d4chinchilla/docs/README.md

# Project Chinchilla Documentation

This repository contains all the documentation for project chinchilla.
The documentation is written in markdown and maybe duplicated in it's specific
repository.
The root of the documentation is [overview.md](overview.md).
