d4chinchilla/docs/buffer/overview.md

# Buffer Overview
Buffer Lead: [Matthew Johns](http://github.com/mjohns4)

Log File: [buffer/log.md](log.md)

## Microcontroller
This buffer uses an STM NUCLEO-L432KC microcontroller board. This is produced by ST Microelectronics and is based off the STM32L432KCU6 microcontroller, which is in turn based off an Arm Cortex-M4 core.

Useful links:

[mbed description](https://os.mbed.com/platforms/ST-Nucleo-L432KC/)

[STM website](https://www.st.com/content/st_com/en/products/evaluation-tools/product-evaluation-tools/mcu-eval-tools/stm32-mcu-eval-tools/stm32-nucleo-boards/nucleo-l432kc.html)

[MCU datasheet](https://www.st.com/resource/en/datasheet/stm32l432kc.pdf)
