d4chinchilla/docs/report/appendixE/minutes.md

# Minutes

## 15:00 16/02/2019
attendees: Francis, Hugo, Mark, Matt J, Tom    
place: level 3 Zepler labs    

- We met and discussed possible project options
- We ruled out basic sensors as those would be too simple
- We eventually decided on a project to detect sound angle over other proposed projects
- Decided project would have a web ui
- Deciding between il matto & display and an LED ring to display output onboard
- Discussed power requirements, and pre-amps
- It would detect sound using four microphones
- It would have a 3D printed case
- Using microcontroller for data collection
- Discussed Raspberry Pi or FPGA for processing
- Split up code into 5 block sections
- Split up project into block sections
- Made github for code and docs

## 10:00 18/02/2019
attendees: All    
place: level 2 Zepler labs    

- Discussed idea from last meeting with everybody
- Confirmed everybody was OK with basic idea
- Specified details for requirements
- Detailed processing methods
- Given everybody access to github and explain usage
- Assigned individual leads for each block

## 11:50 19/02/2019
attendees: All + Tim Forcer
place: level 2 Zepler labs

- Discussed project idea and specific details
- We were advised on the importance of specifying interfaces
- We were advised that we should make test data so that each block can be tested seperately to each other
- We were told about the format of the project and advised about individual roles

## 15:00 19/02/2019
attendees: All    
place: level 3 Zepler labs    

- Discussed plan in detail in response to Tim Forcer's comments
- Established schematics for some components
- Confirmed which parts are needed
- Found parts from RS components and Onecall (Farnell)
- Created parts list

## 15:00 21/02/2019
attendees: Hugo, Mark, Will    
place: level 3 Zepler labs    

- Discussed design summary
- Discussed individual roles
- Discussed individual module specifications
- Discussed costing
- Discussed construction methods
- Discussed Risk assessment
- Discussed project proposal form
