d4chinchilla/docs/report/appendixA/DesignCompletionForm-complete.pdf

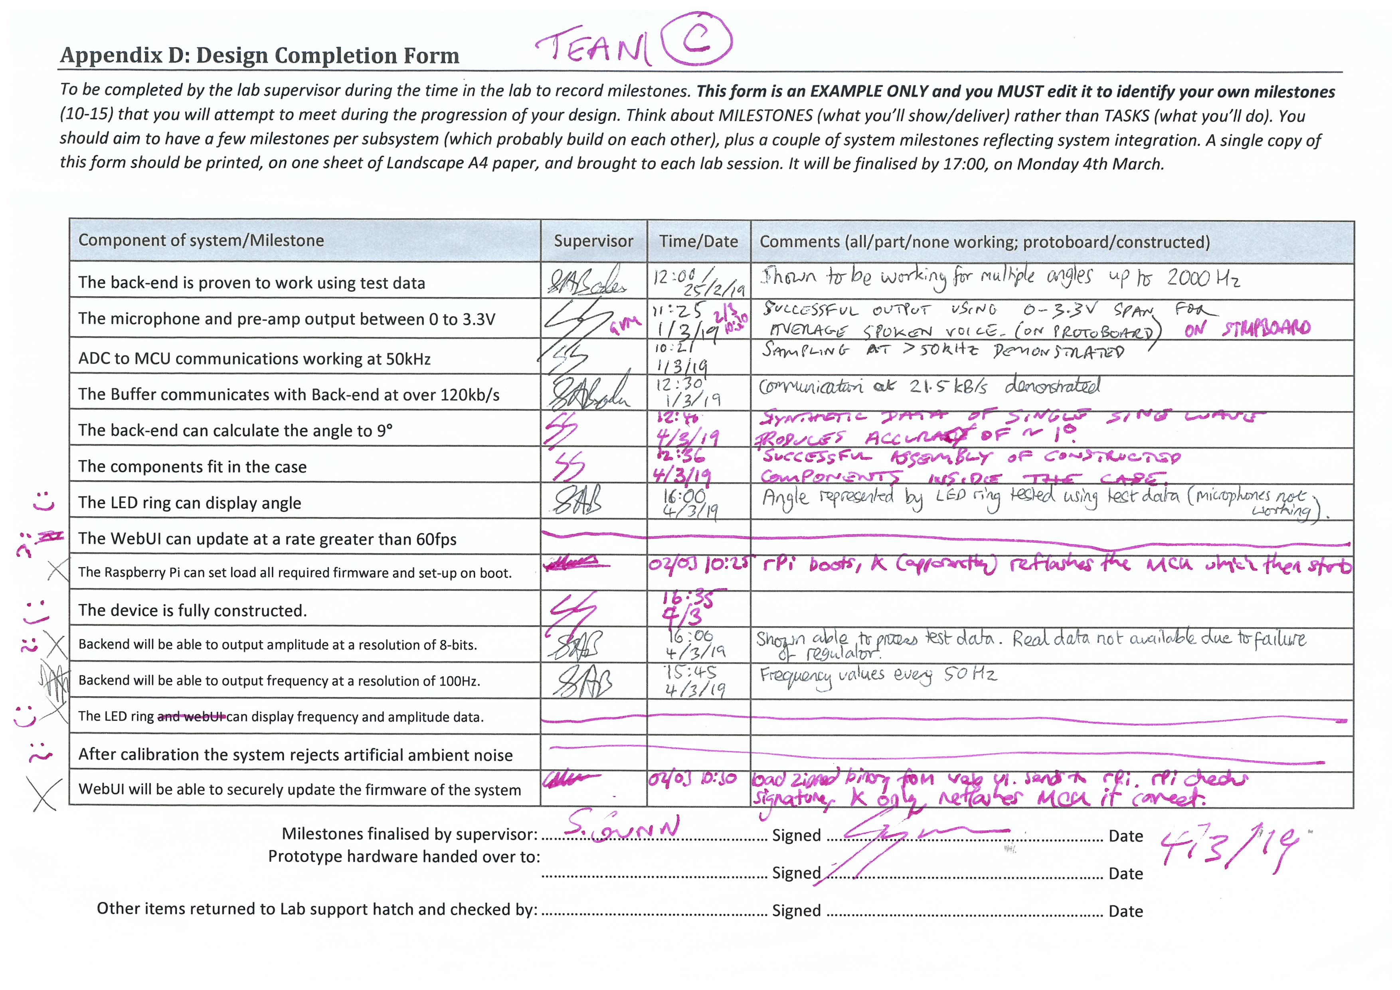
[picture p8: page 1]
