d4chinchilla/docs/report/appendixB/actualprojectactivities/francis.pdf

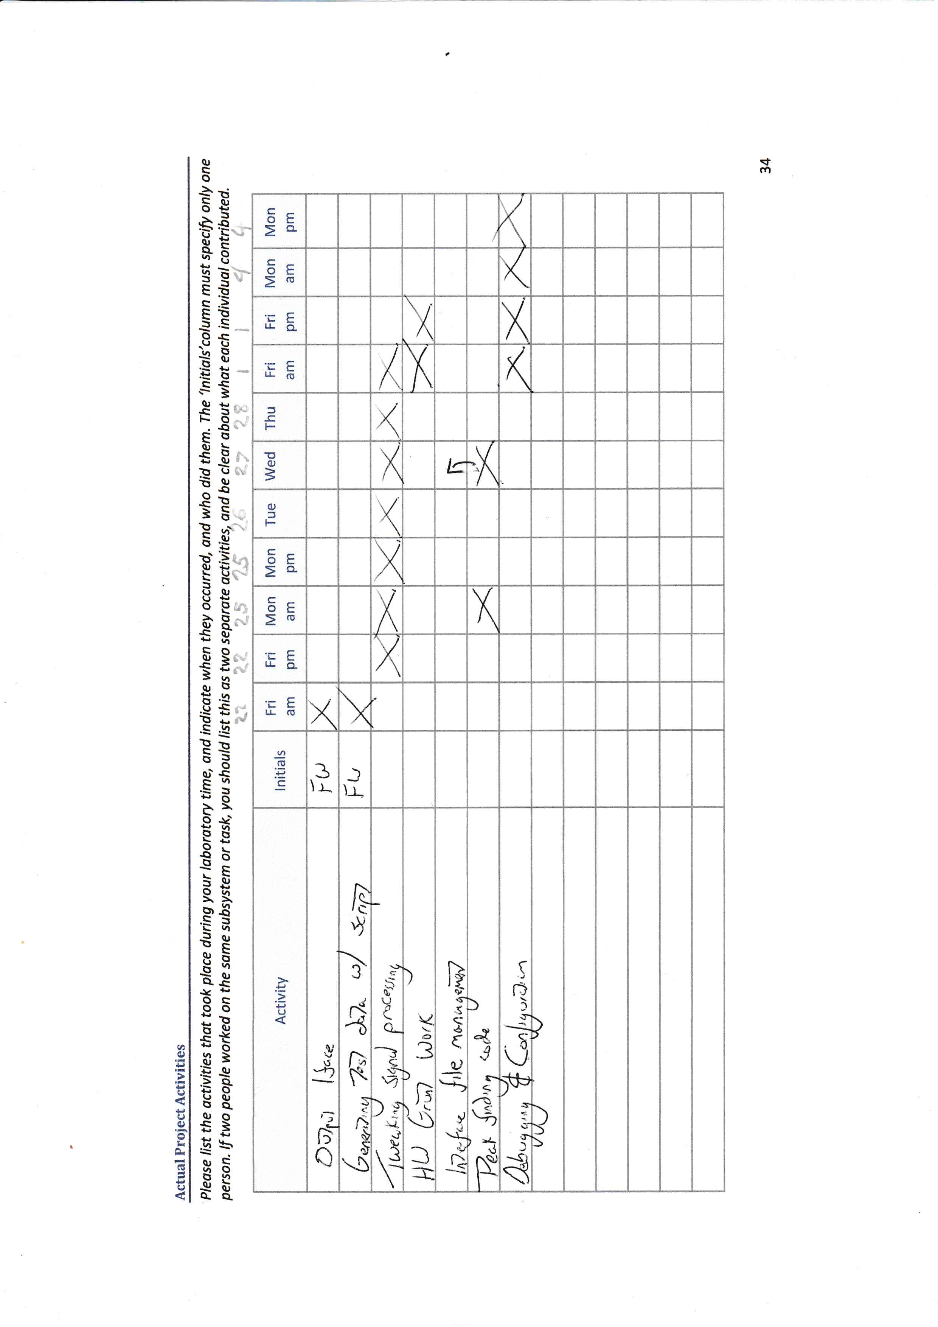
[picture p9: page 1]
