d4chinchilla/docs/hardware/concept_render.png

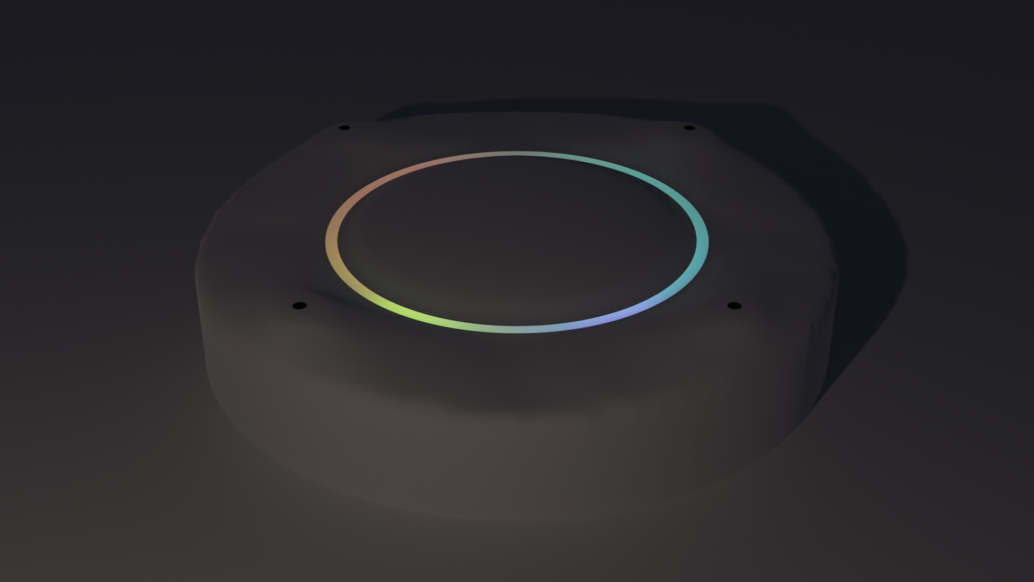
hardware/concept_render.png
