d4chinchilla/docs/Photos/00000PORTRAIT_00000_BURST20190304165032344.jpg

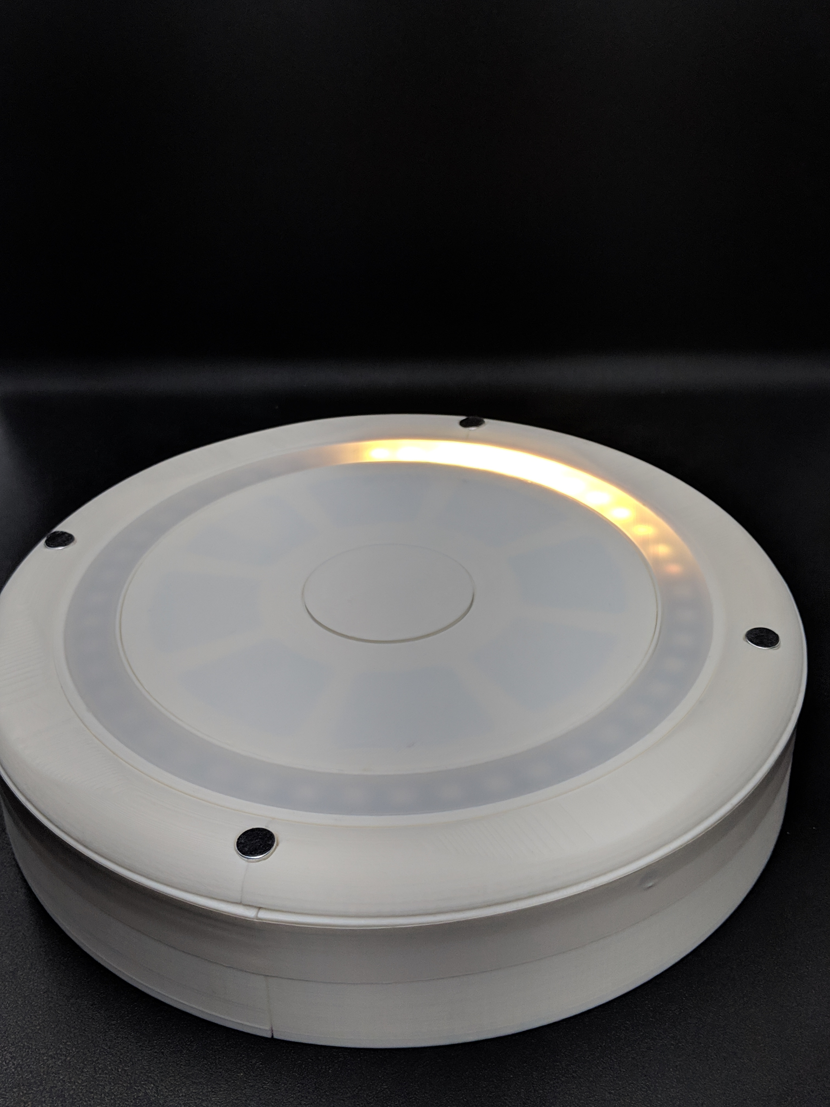
Photos/00000PORTRAIT_00000_BURST20190304165032344.jpg
