d4chinchilla/docs/Photos/00000PORTRAIT_00000_BURST20190304165042817.jpg

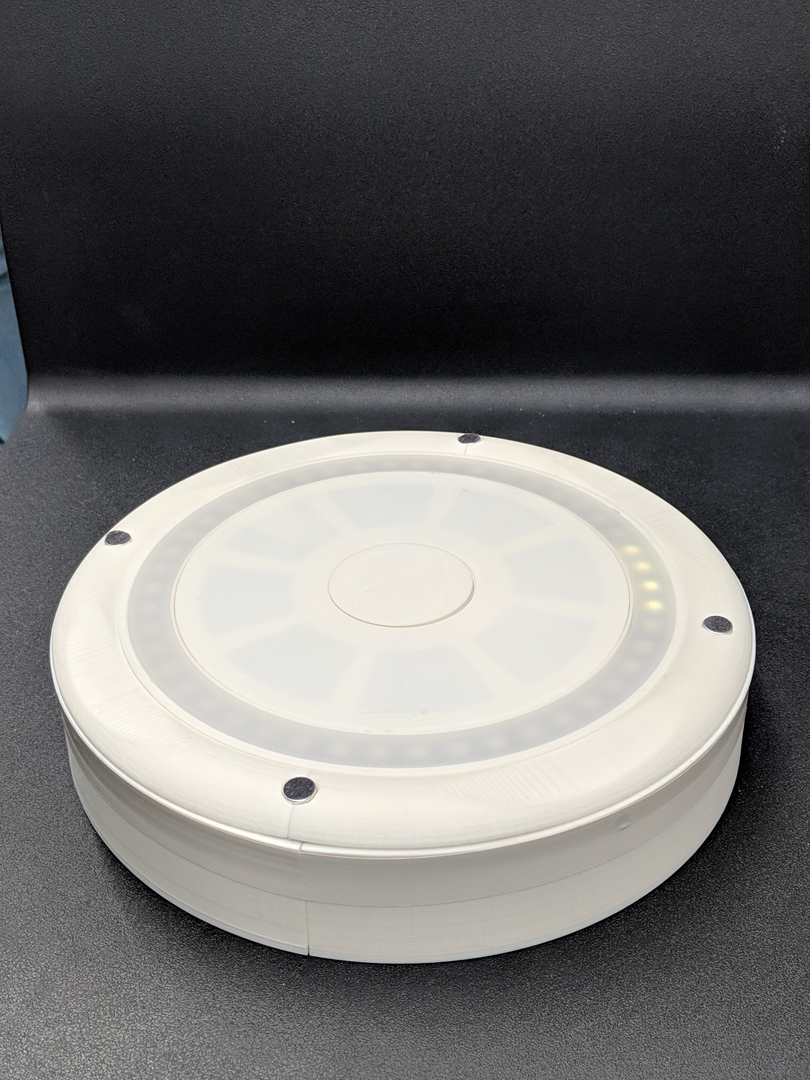
Photos/00000PORTRAIT_00000_BURST20190304165042817.jpg
