d4chinchilla/docs/Photos/00100dPORTRAIT_00100_BURST20190304165030741_COVER.jpg

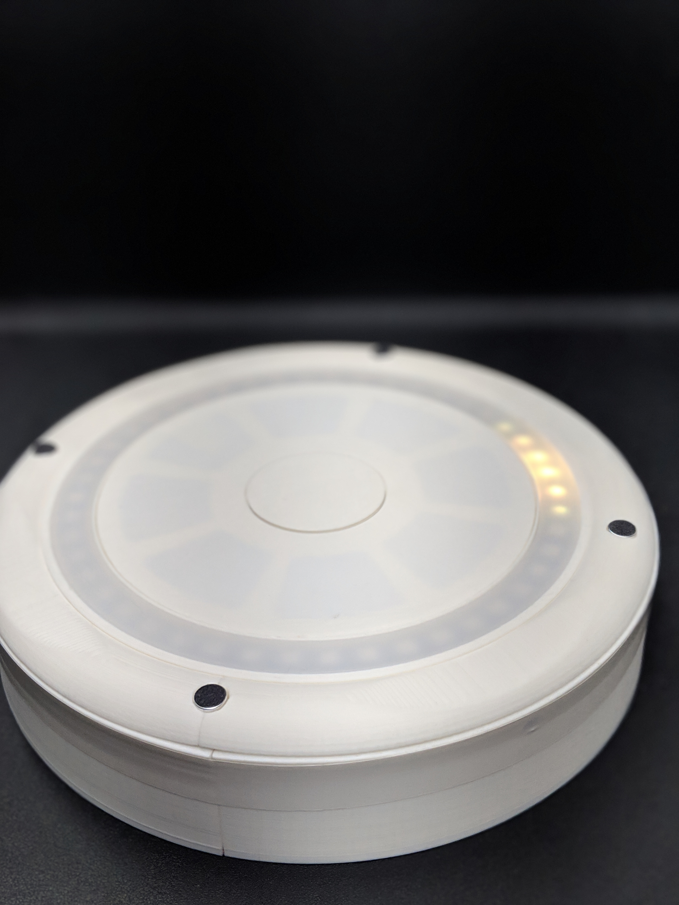
Photos/00100dPORTRAIT_00100_BURST20190304165030741_COVER.jpg
