d4chinchilla/docs/report/appendixB/actualprojectactivities/johns.png

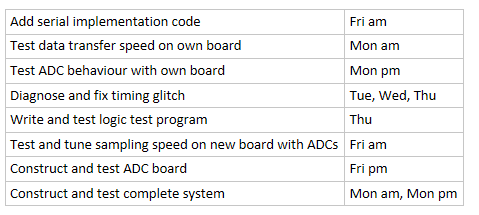
report/appendixB/actualprojectactivities/johns.png
