d4chinchilla/docs/report/appendixB/actualprojectactivities/mark.jpg

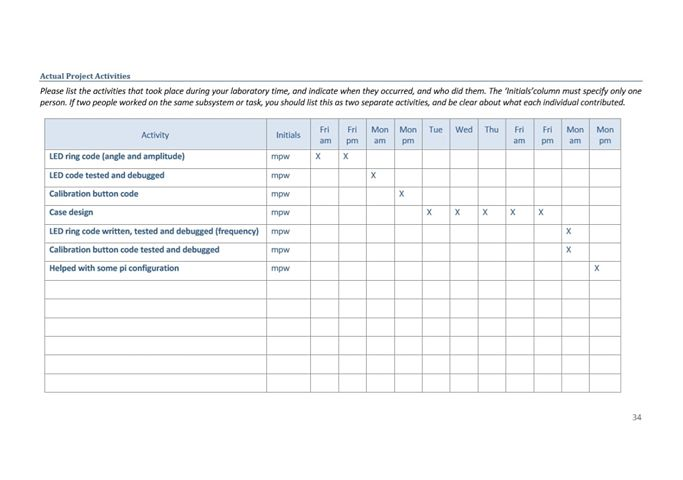
report/appendixB/actualprojectactivities/mark.jpg
