d4chinchilla/docs/report/appendixB/actualprojectactivities/will.png

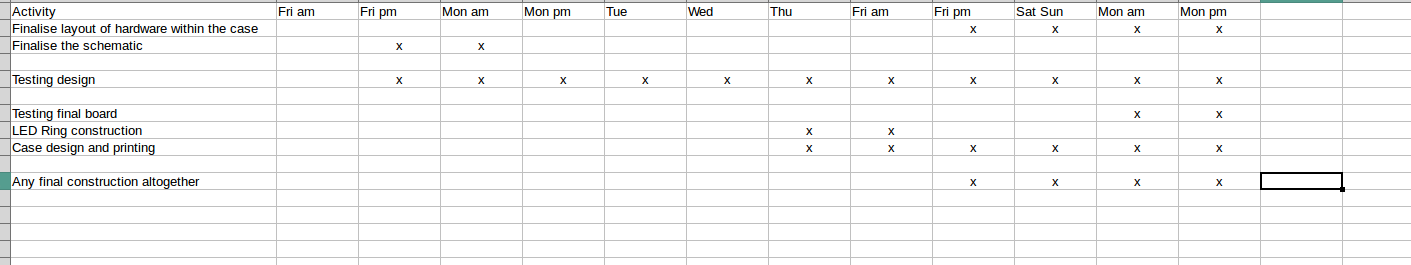
report/appendixB/actualprojectactivities/will.png
