d4chinchilla/docs/report/appendixC/schematic.png

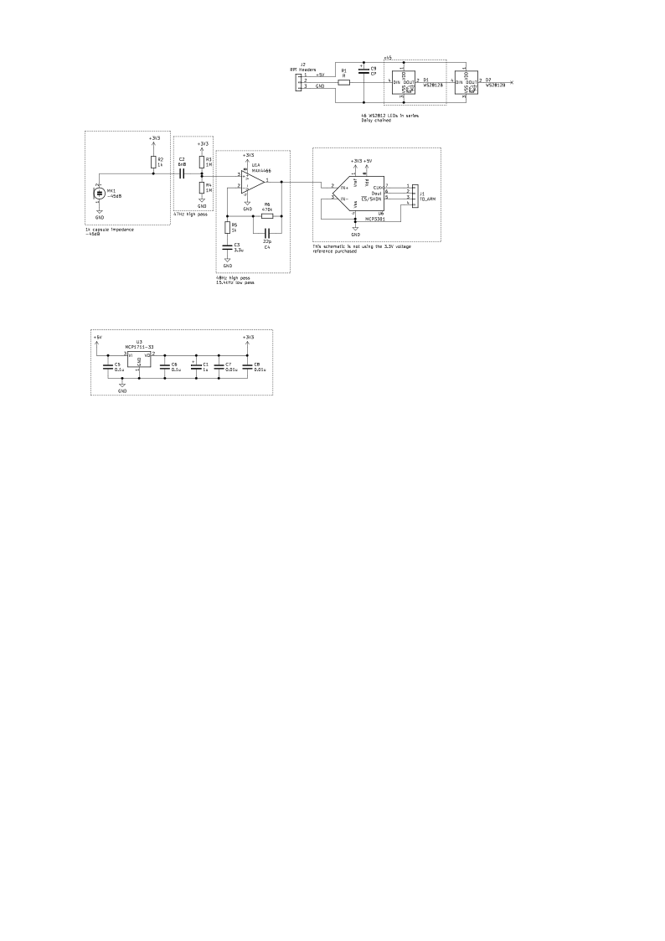
report/appendixC/schematic.png
