d4chinchilla/docs/report/pictures/FinalProduct.jpg

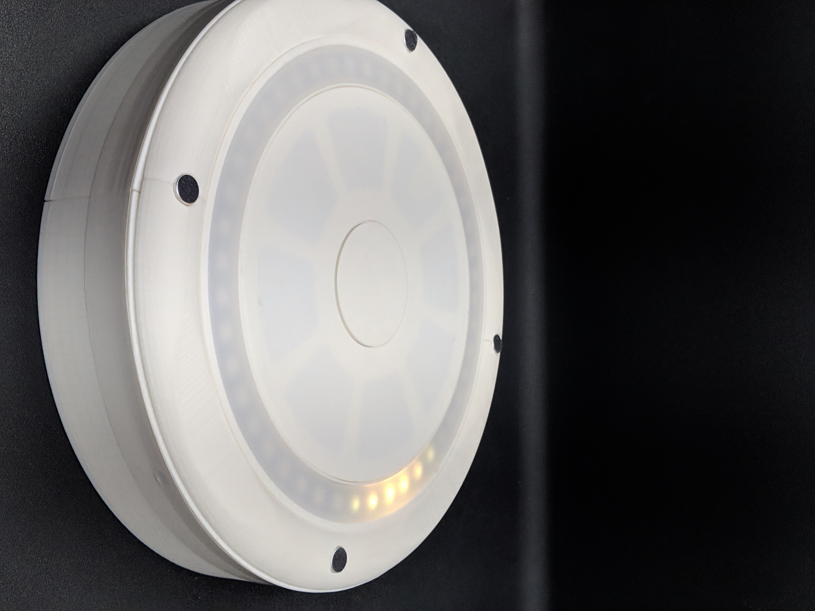
report/pictures/FinalProduct.jpg
