d4chinchilla/docs/hardware/cost_estimation.ods

Number of units: | 1000 |  |  | 1000 is quite a high volume of units to be selling of this product.
 |  |  |  | 100 Would probably be more realistic depending on the final price but
Costing assumptions: |  |  |  | any reasonable RRP would be unattainable with that low a volume.
Design is refined into a single 4 layer board
The ARM chip is integrated into the main board
Raspberry pi remains a plugin module to minimise redesign costs
An additional filter is implemented to reduce noise
Alternate parts are not sourced
No special passives are required
Case is injection moulded at volume
Items in italics have estimate costs
Per unit costs: | £82.52 |  |  | Amortised cost per unit: | £142.91
Item | Qty | Cost per @vol | Total cost | Item | Cost | Additional cost per unit
STM32L432KC | 1 | £2.27 | £2.27 | Compliance testing | £2,000.00 | £2.00
Raspberry Pi | 1 | £21.22 | £21.22 | Tooling costs | £800.00 | £0.80
ADC MCP3301 | 4 | £1.35 | £5.40 | Development hours | £40,000.00 | £40.00
LDO MCP1711 | 4 | £0.20 | £0.82 | Development components | £110.88 | £0.11
WS2812 | 46 | £0.34 | £15.64 | Development overheads | £100,000.00 | £100.00
OpAmp LMV358ID | 4 | £0.14 | £0.56
Vref MCP1501-33 | 4 | £0.46 | £1.82 | Total cost per unit: | £225.43
AOM-654P-R | 4 | £0.47 | £1.87
Preamp MAX4466 | 4 | £0.27 | £1.08 | Going on a rule of cost * 1.5 as a rule of thumb
MicroSD Card | 1 | £4.99 | £4.99 | Cost * 2 would be ideal but is an accessibility product
Passives | 1 | £2.00 | £2.00
Battery (inc management) | 1 | £15.00 | £15.00 | Cost * 1.5: | £338.14
Mainboard PCB | 1 | £5.25 | £5.25
Board assembly | 1 | £0.60 | £0.60 | Need to take into account 20% vat
Case | 1 | £4.00 | £4.00
Final assembly and test | 1 | £10.00 | £10.00 | Recommended Retail Price: | £405.77
