d4chinchilla/docs/hardware/parts.csv

Item | Quantity | Unit cost | Total | Link
STM32 Nucleo-32 STM32L432KC Dev. Board | 1 | £8.32 | £8.32 | https://uk.rs-online.com/web/p/processor-microcontroller-development-kits/1438574/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
MCP3301-CI/P Analogue to Digital Converter, 13 bit, 100 kSPS, Differential, Serial, SPI, Single, 4.5 V | 4 | £1.75 | £7.00 | https://onecall.farnell.com/microchip/mcp3301-ci-p/ic-13bit-adc-1ch-dip8-3301/dp/1332099
1MS1T1B5M1QE Toggle Swich | 1 | £1.69 | £1.69 | https://onecall.farnell.com/multicomp/1ms1t1b5m1qe/switch-spdt-2-0a-250v/dp/9473378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
MCP1711T-33I/OT 3.3V LDO | 4 | £0.24 | £0.98 | https://onecall.farnell.com/microchip/mcp1711t-33i-ot/ldo-fixed-3-3v-0-15a-sot-23-5/dp/2851552?st=mcp1711
Alitove 100 pcs ws2812B addressable LED pixel light rgb 5V DC | 1 | £17.99 | £17.99 | https://www.amazon.co.uk/ALITOVE-100pcs-WS2812B-Addressable-Arduino/dp/B01JTVRNFA?srs=10938069031
RS Pro Power Bank | 1 | £17.89 | £17.89 | https://uk.rs-online.com/web/p/power-banks/7757517/?searchHistory=%7B%22enabled%22%3Atrue%7D
LVM358 Opamps | 4 | £0.56 | £2.24 | https://onecall.farnell.com/texas-instruments/lmv358id/op-amp-dual-low-volt-rro-p-soic8/dp/1105913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
MCP1501T-33E/CHY 3.3V References | 4 | £0.60 | £2.41 | https://onecall.farnell.com/microchip/mcp1501t-33e-chy/voltage-ref-series-fixed-3-3v/dp/2857779
MAX446EXK+T Microphone Preamp | 4 | £0.32 | £1.28 | https://onecall.farnell.com/maxim-integrated-products/max4466exk-t/audio-amp-600khz-sc-70-5/dp/2514501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
AOM-6545P-R Microphone | 4 | £1.27 | £5.08 | https://onecall.farnell.com/projects-unlimited/aom-6545p-r/microphone-omni-pcb-9-4mm/dp/1193036?st=1193036
Raspberry Pi 3 | 1
Micro SD Card for Pi | 1
Perfboard | N/A
Female Pin Headers | N/A
 |  | Total | 64.88
