d4chinchilla/docs/forms/submitted_requisitions_form.xlsx

Group: Chinchilla |  | Project leader: Hugo McNally | Supplier: Onecall
Column1 | Column2 | Column3 | Column4 | Column5 | Column6
Quantity | Suppliers stock code | Description | Unit price (ex. VAT) | Total price (ex. VAT) | In stock
8 | 1332099 | MCP3301-CI/P ADC | 1.75 | 14 | 626
8 | 2851552 | MCP1711T-33I/OT 3.3V LDO | 0.244 | 1.95 | 794
1 | 2801872 | LED strip | 23.2 | 23.2 | 192
8 | 2857779 | MCP1501T-33E/CHY 3.3V Reference | 0.603 | 4.82 | 3.62
8 | 2514501 | MAX4466EXK+T Microphone Preamp | 0.319 | 2.55 | 1637
8 | 1193036 | AOM-6545P-R Microphone | 1.27 | 10.16 | 22
8 | 1105913 | LMV358 OpAmp | 0.556 | 4.45 | 25154
2 | 9473378 | 1MS1T1B5M1QE Toggle Switch | 1.67 | 3.34 | 45626
Group: Chinchilla |  | Project leader: Hugo McNally | Supplier: RS
Column1 | Column2 | Column3 | Column4 | Column5 | Column6
Quantity | Suppliers stock code | Description | Unit price (ex. VAT) | Total price (ex. VAT) | In stock
1 | 775-7517 | RS Pro Power Bank | 17.89 | 17.89 | 142
1 | 143-8574 | Nucleo-32 STM32L432KC Dev Board | 8.32 | 8.32 | 463
