d4chinchilla/docs/mechanical/led_ring_assembly_jig.stl

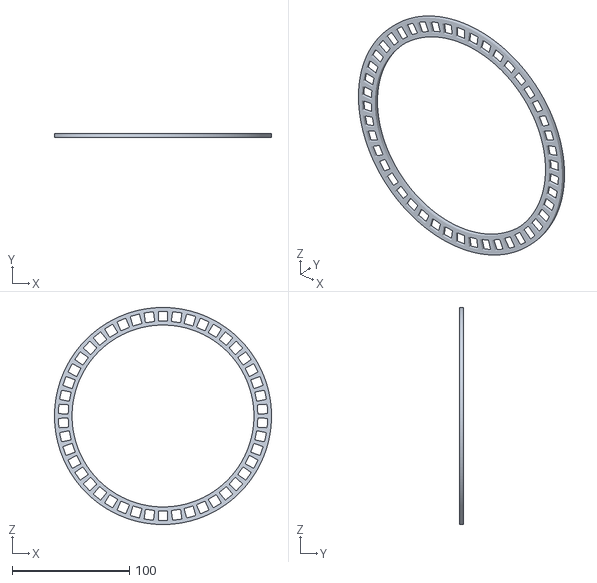
[picture p25: CAD file, 2019-03-08]
mechanical/led_ring_assembly_jig.stl
185.0 x 3.00 x 185.0
