d4chinchilla/docs/mechanical/assembly_jig_section.stl

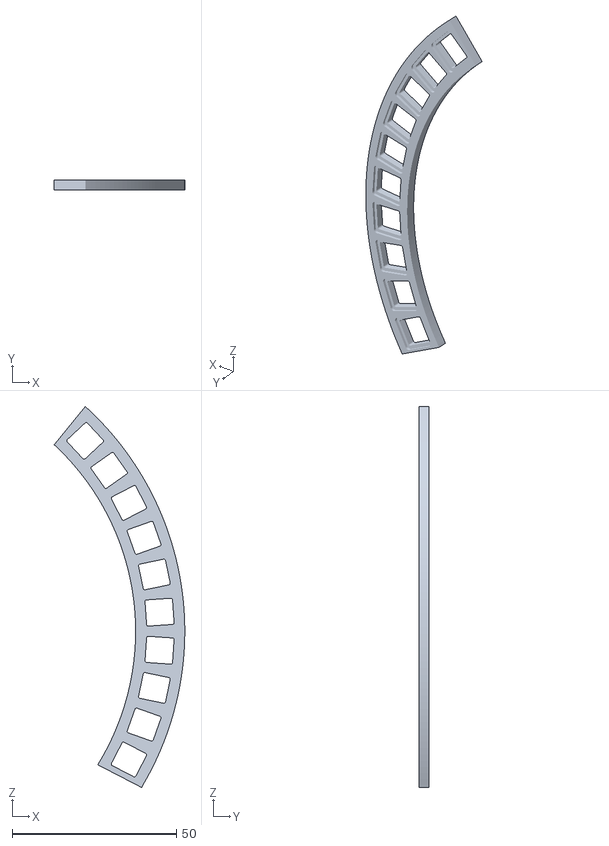
[picture p26: CAD file, 2019-03-08]
mechanical/assembly_jig_section.stl
39.8 x 3.00 x 116.1
