d4chinchilla/docs/mechanical/test_ring.stl

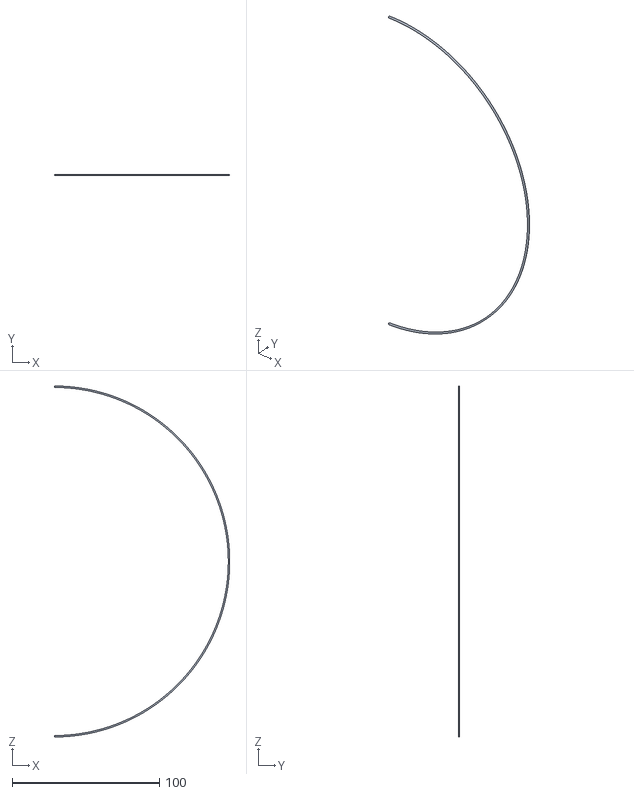
[picture p27: CAD file, 2019-03-08]
mechanical/test_ring.stl
119.0 x 1.00 x 238.0
