d4chinchilla/docs/mechanical/lid.stl

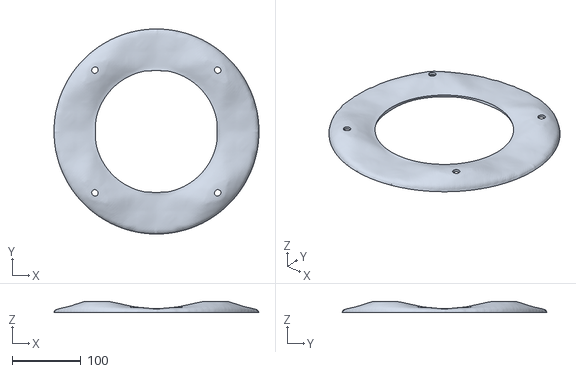
[picture p28: CAD file, 2019-03-08]
mechanical/lid.stl
299.2 x 299.3 x 16.7
