d4chinchilla/docs/mechanical/bucket.stl

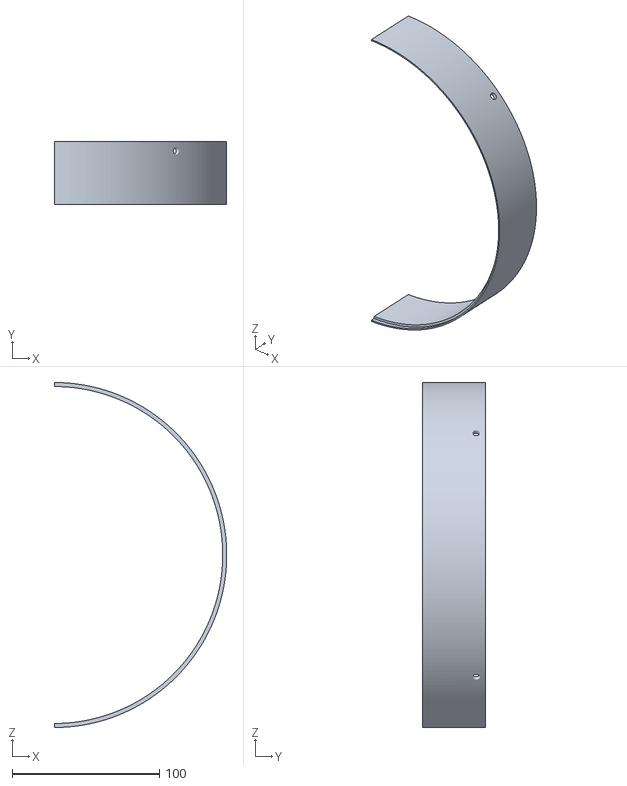
[picture p29: CAD file, 2019-03-08]
mechanical/bucket.stl
117.0 x 43.0 x 234.0
