d4chinchilla/docs/mechanical/button_barrel.stl

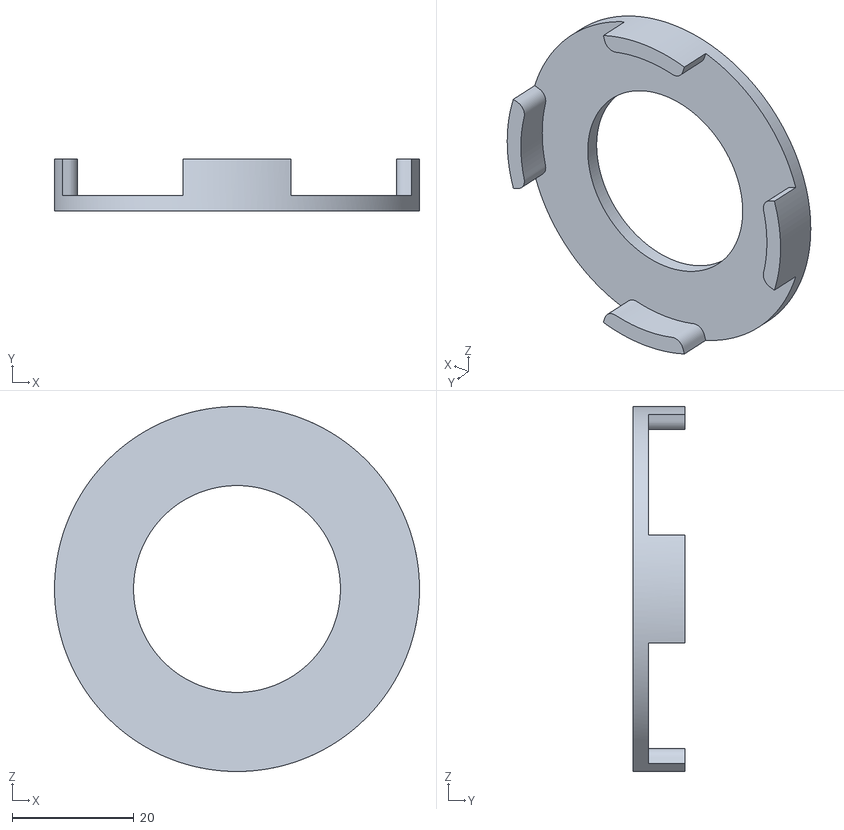
[picture p30: CAD file, 2019-03-08]
mechanical/button_barrel.stl
60.0 x 8.50 x 60.0
