d4chinchilla/docs/mechanical/locking_spud.stl

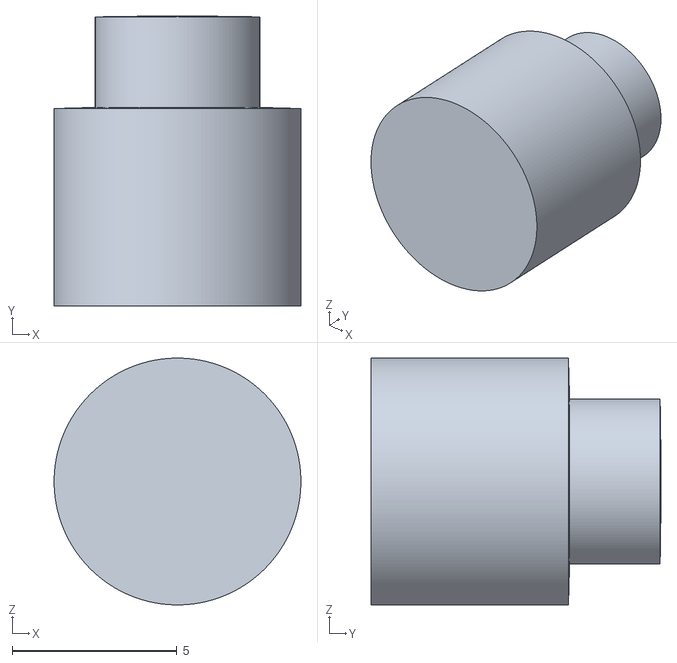
[picture p31: CAD file, 2019-03-08]
mechanical/locking_spud.stl
7.50 x 8.81 x 7.50
