d4chinchilla/docs/mechanical/led_holster.stl

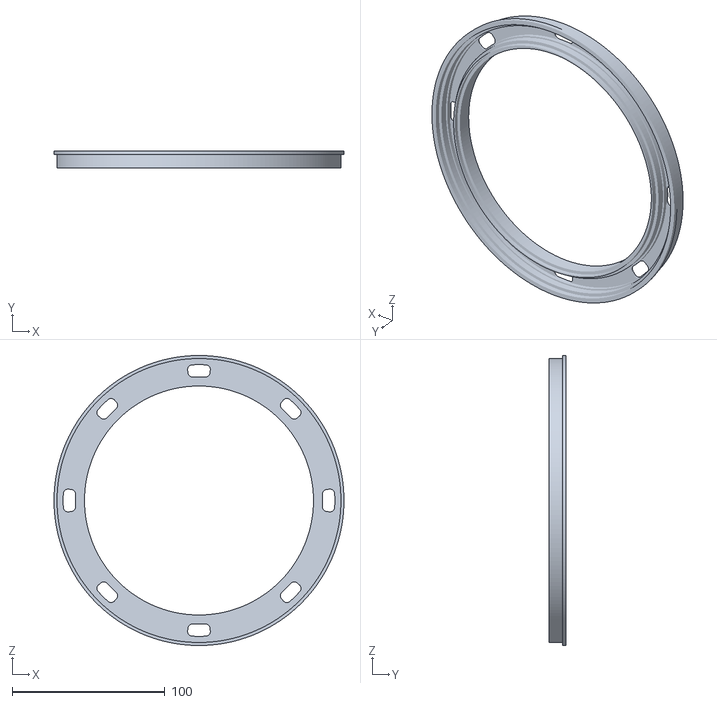
[picture p32: CAD file, 2019-03-08]
mechanical/led_holster.stl
190.0 x 11.3 x 190.0
