d4chinchilla/docs/mechanical/button.stl

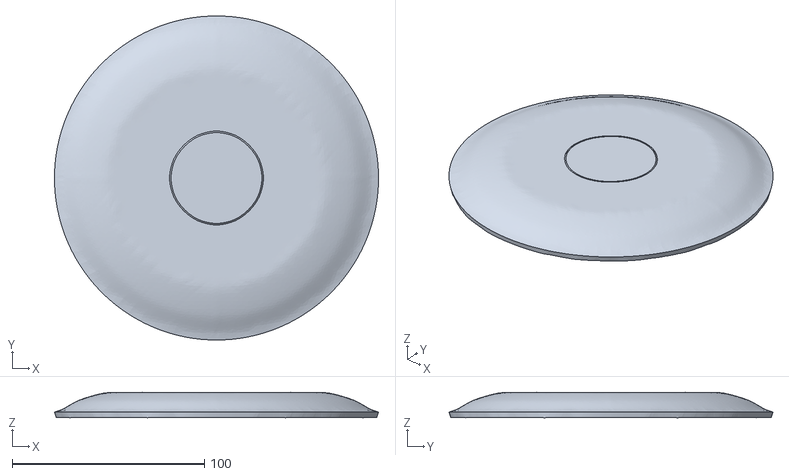
[picture p33: CAD file, 2019-03-08]
mechanical/button.stl
168.5 x 168.5 x 13.3
