d4chinchilla/docs/mechanical/button_test.stl

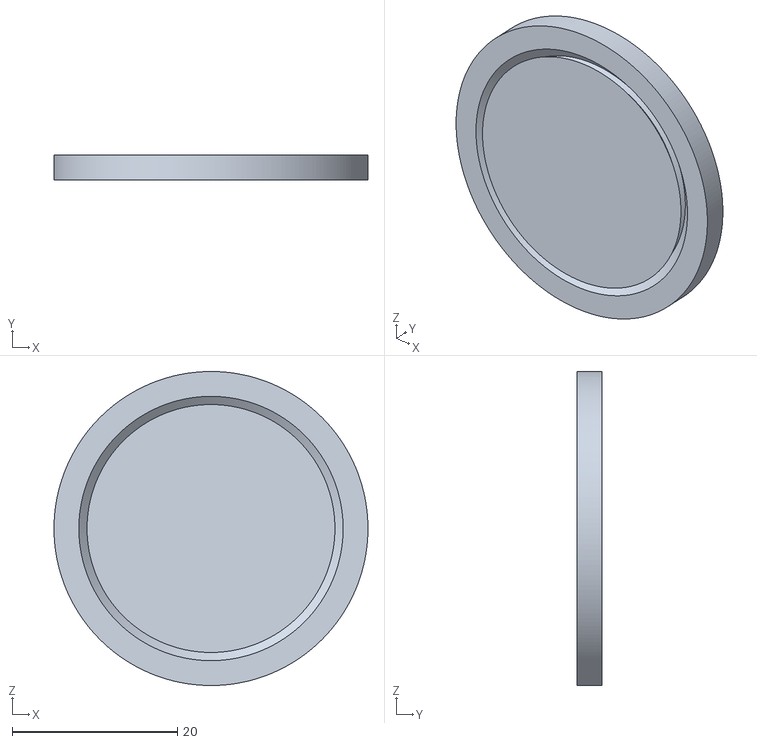
[picture p34: CAD file, 2019-03-08]
mechanical/button_test.stl
38.0 x 3.00 x 38.0
