d4chinchilla/docs/mechanical/test_led_holster.stl

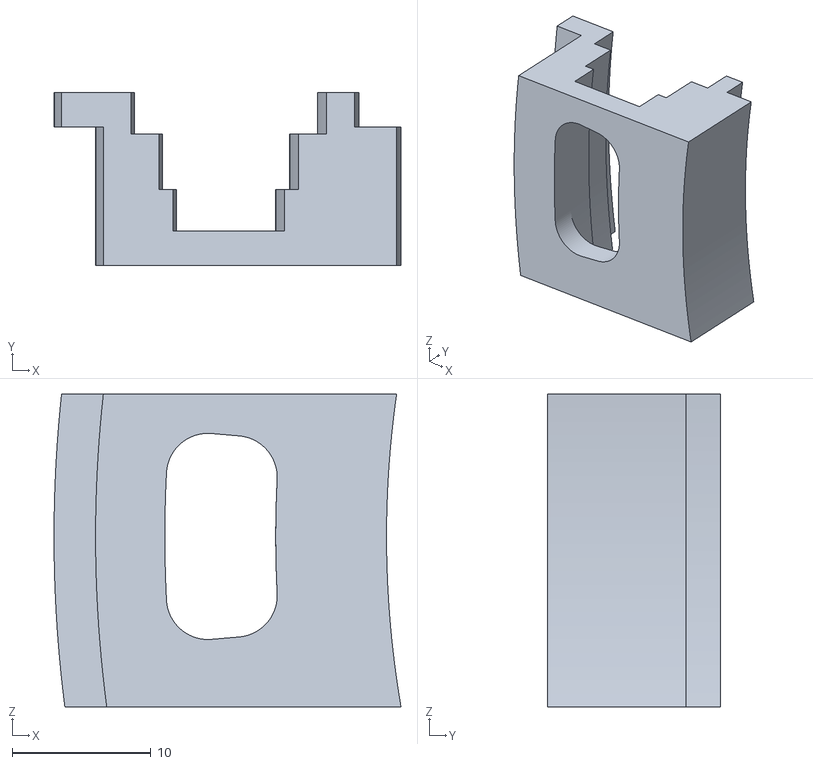
[picture p35: CAD file, 2019-03-08]
mechanical/test_led_holster.stl
25.0 x 12.5 x 22.6
