d4chinchilla/docs/mechanical/centre.stl

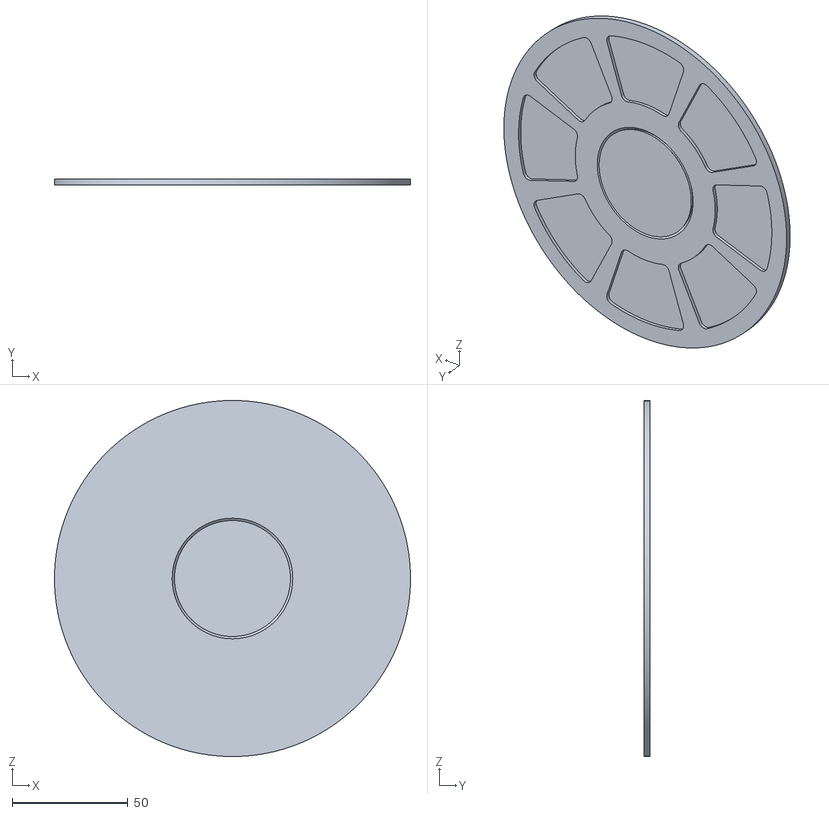
[picture p36: CAD file, 2019-03-08]
mechanical/centre.stl
153.5 x 2.50 x 153.5
