d4chinchilla/docs/mechanical/receiving_clip.stl

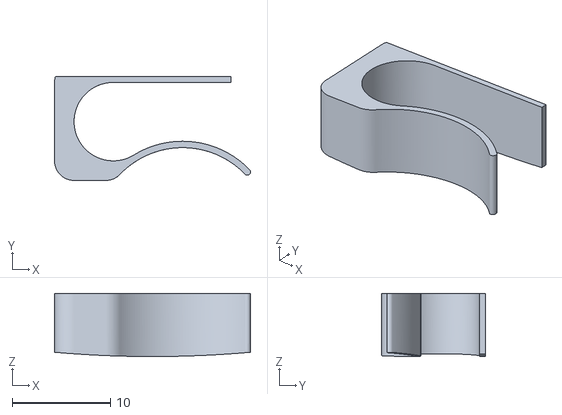
[picture p37: CAD file, 2019-03-08]
mechanical/receiving_clip.stl
20.0 x 10.6 x 6.44
