d4chinchilla/docs/mechanical/wibble_ring.stl

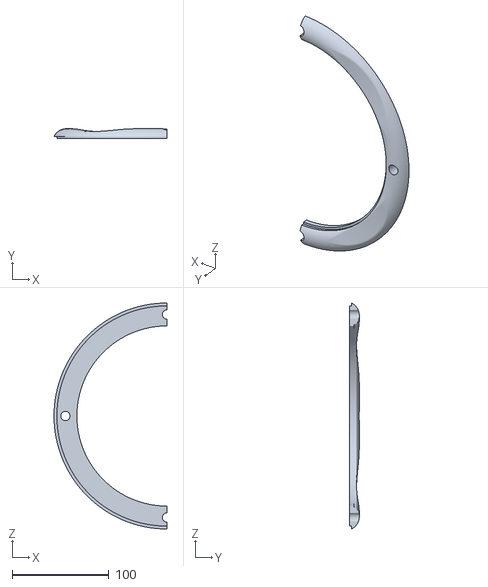
[picture p38: CAD file, 2019-03-08]
mechanical/wibble_ring.stl
117.0 x 10.0 x 234.0
