d4chinchilla/docs/mechanical/base.stl

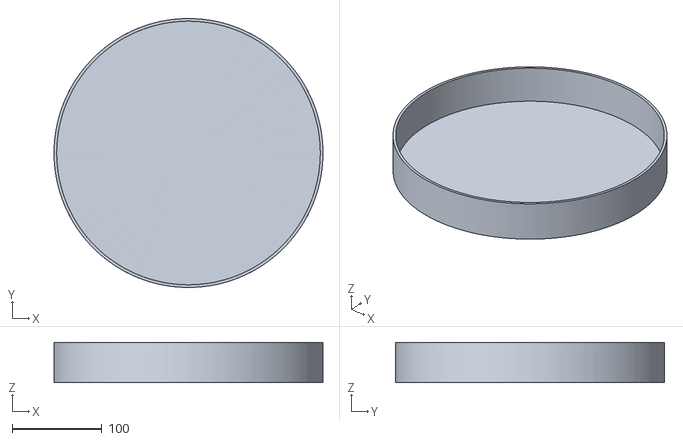
[picture p39: CAD file, 2019-03-08]
mechanical/base.stl
299.8 x 299.8 x 44.7
