d4chinchilla/docs/mechanical/jig_test.stl

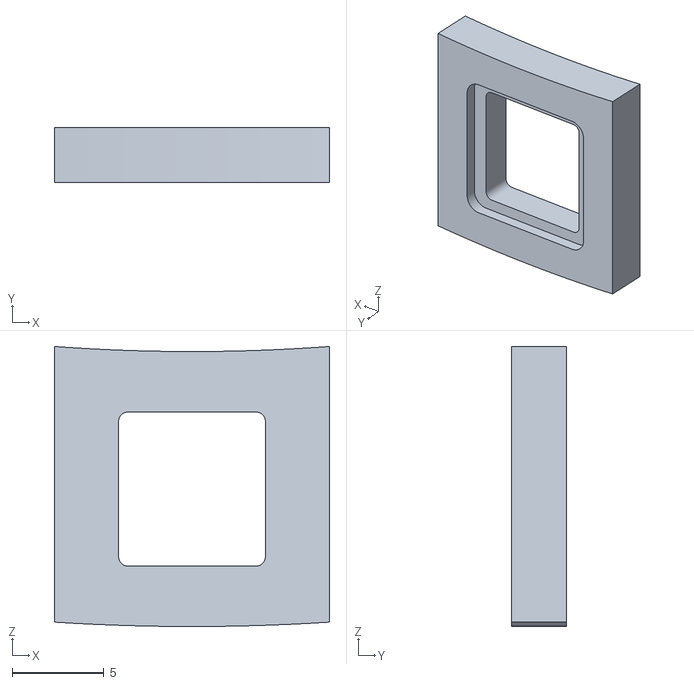
[picture p40: CAD file, 2019-03-08]
mechanical/jig_test.stl
15.0 x 3.00 x 15.3
