d4chinchilla/docs/(list of files, cad)

Other CAD files:
mechanical/assy.iam
mechanical/bucket.ipt
mechanical/button_barrel.ipt
mechanical/button_test.ipt
mechanical/centre.ipt
mechanical/frosted_ring.ipt
mechanical/jig_test.ipt
mechanical/led_holster.ipt
mechanical/led_ring_assembly_jig.ipt
mechanical/locking_spud.ipt
mechanical/receiving_clip.ipt
mechanical/test_ring.ipt
mechanical/wibble_ring.ipt
