d4chinchilla/docs/hardware/construction_notes.txt

On stripboard arrange rails:

------------ +5V
------------ +3V3
------------ 0V
------------
------------
