d4chinchilla/docs/hardware/schematic.pdf

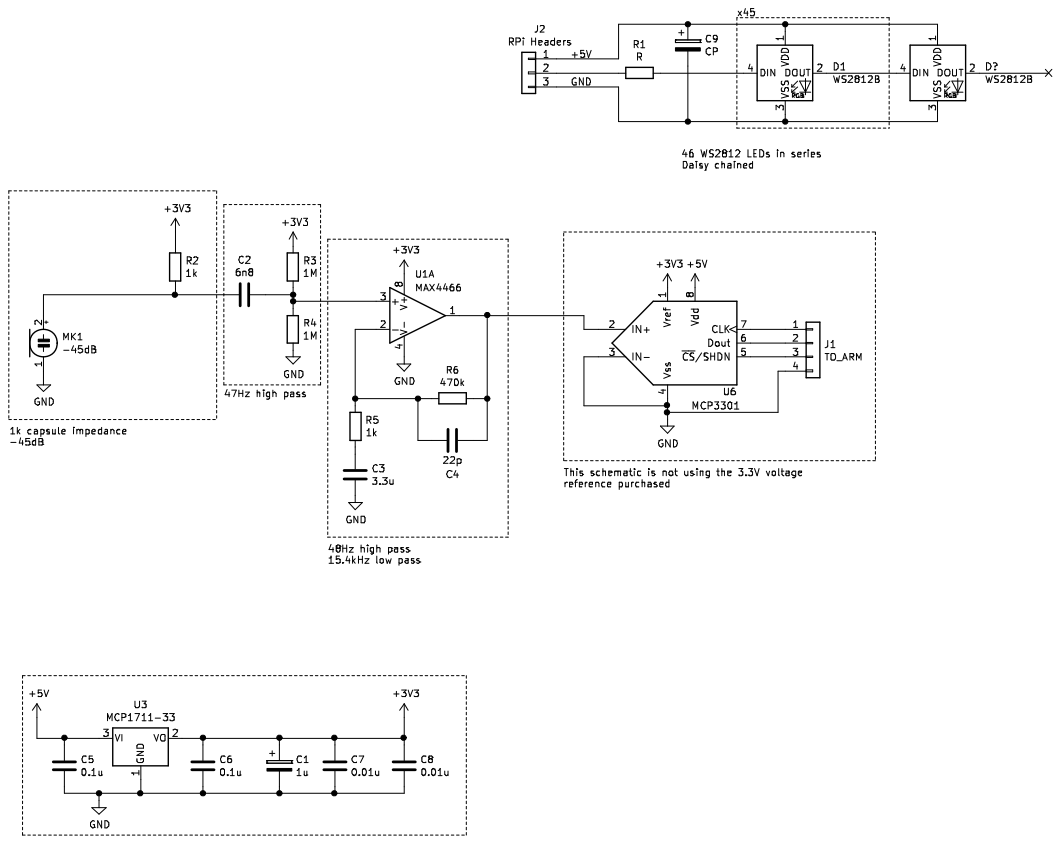
[picture p41: page 1]
