d4chinchilla/docs/(commit log)

2019-02-18 Added parts list - some tentative choices added
    [parts.xlsx]
2019-02-18 Added details of buffer MCU board
2019-02-18 Added micro SD so we can get one from lab stores
    [parts.xlsx]
2019-02-18 Update description for usage
    Added description detailing how raspberry pi is setup for neopixels
2019-02-19 moved parts.xlsx into the hardware directory
    [parts.xlsx]
2019-02-19 changed 'Schematic' subsection to 'Block Diagram'.
2019-02-19 Added basic mic to ADC interface voltages
2019-02-19 Updated parts list
    [parts.xlsx]
2019-02-19 updated block diagram to reflect Led Controller's ownership of the calibration button.
2019-02-19 Added neopixels to parts list
    [parts.xlsx]
2019-02-19 Added power hardware overview
2019-02-19 Made parts list a .csv
    [parts.csv, parts.xlsx]
2019-02-19 Updated log, parts list near completion
    [parts.csv]
2019-02-20 Updated name of led strip
    [parts.csv]
2019-02-20 Added led pixels to parts list
    [parts.csv]
2019-02-20 Correct price for led pixels
    [parts.csv]
2019-02-20 Selected led pixels with good delivery time
    [parts.csv]
2019-02-21 Added submitted requisitions form
    [submitted_requisitions_form.xlsx]
2019-02-21 Corrected parts list to align with requested parts
    [parts.csv]
2019-02-21 Created calibration button communications
2019-02-23 Added button hardware requirements
2019-03-01 Added Schematic
2019-03-01 Added stripboard rail notes
2019-03-07 Updated schematic and included .svg for editing
2019-03-08 added team report so far
    [cost_estimation.ods]
2019-03-08 Added all 3d models at finished state
    [assembly_jig_section.stl, assy.iam, base.stl, bucket.ipt, bucket.stl, button.stl, button_barrel.ipt, button_barrel.stl]
2019-03-08 Added cost estimation
    [cost_estimation.ods]
