d4chinchilla/docs/Photos/00000PORTRAIT_00000_BURST20190304164846730.jpg

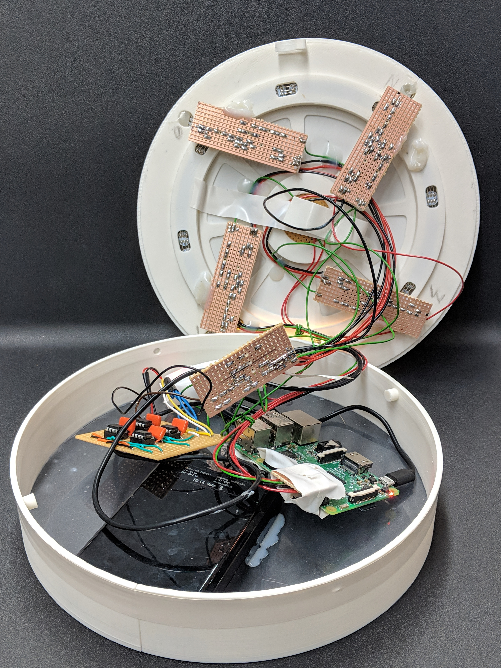
Photos/00000PORTRAIT_00000_BURST20190304164846730.jpg
